amedes/fx25-kiss-tnc/README.md

# FX.25 KISS TNC

KISS TNC program supporing FX.25 error correction protocol.

Hardware components
* TCM3105
* ESP32-WROOM-32
