amedes/fx25-kiss-tnc/manual/FX25-KISS-TNC-manual2.pdf

FX.25 KISS TNC 製作説明書(基本編) 2019/7/19
部品表
部品番号 | 型番/値 | 種類 | 購入情報(通販コード) | 注
A1 | AE-FT234X | USB シリアル I/F | 秋月 M-08461
C1 | 10uF | 積層セラミック | 秋月 P-03095 | 5mm ピッチ
C2,C4,C6, C7,C8,C9,C12 | 0.1uF | 積層セラミック | 秋月 P-04064 | 2.54mm ピッチ
C3,C5 | 1uF | 積層セラミック | 秋月 P-04066 | 2.54mm ピッチ
C10,C11 | 33pF | セラミックコンデンサ | 秋月 P-11138 | ディスク型
D1,D2,D3 | 1SS178 | ダイオード | 秋月 I-07783
D4 | | LED | | 3mm 砲弾型
J1 | MJ-4PP-9 | 3.5φ4 極ジャック | 秋月 C-06070
J2 | B4B-XH-A | ボックスピンヘッダ | 秋月 C-12249 | オプション
J3 | | 2x9 ピンヘッダ | | オプション 2.54mm ピッチ
J4 | PJ-2694 | 2.5φ4 極ジャック | aitendo PJ-2694
JP1 | 2P ピンヘッダ ジャンパーピン | ピンヘッダ ジャンパーピン | 秋月の細ピンヘッダ等 秋月 P03687 等 | 2.54mm ピッチ
Q1,Q2 | DTC143EL | デジタルトランジスタ | 秋月 I-12469
R1,R3,R4, R5,R6*,R7 | 10kΩ | 抵抗 1/6W | 秋月 R-16103
R2 | 100kΩ | 抵抗 1/6W | 秋月 R-16104
R8 | 1kΩ | 抵抗 1/6W | 秋月 R-16102 | LED 用抵抗
RV1 | 50kΩ | 半固定抵抗 | 秋月 P-03281 | Bourns3362P
RV2,RV3 | 100kΩ | 半固定抵抗 | 秋月 P-03283 | Bourns3362P
U1 | ESP-WROOM-32 | WiFi モジュール | 秋月 M-11647
U2 | TCM3105 IC ソケット 16P | モデムチップ IC ソケット | 丹青通商？
U3 | LP2950L-3.3V | レギュレータ | 秋月 I-08749
Y1 | 水晶 4.4336MHz | 水晶発振子 | aitendo HC49S | 4.433619MHz 選択
SW1 | TVBP06-B043CB | タクトスイッチ | 秋月 P-08073

*R6 の抵抗値は無線機の仕様に合わせて下さい

J1/J4 と J2 は無線機との接続に合わせてどちらかあれば OK。
この他に無線機との接続用のケーブルが必要。
(J1/J4 を使う場合は、3.5φミニプラグケーブルと 2.5φミニミニプラグケーブル。J2 を使う場合は、ケーブル を自作する必要がある)
※WiFi を使う場合は、U3 を TA48033S に変更(秋月入手可能，向きに注意。C5,C6 も付属のコンデンサに変え る)。更に AE-FT234X のリセッタブルヒューズを容量の大きいものに取り替える。

※ESP-WROVER-B を使う場合は、C1 を 22uF に替える

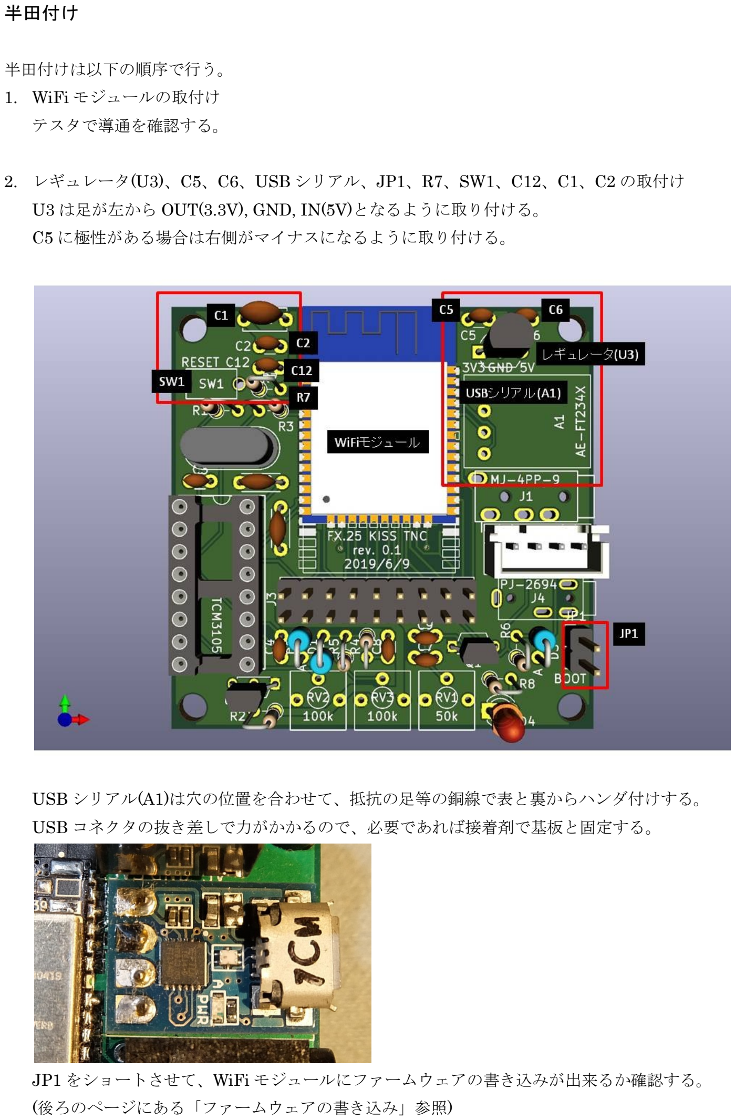
[picture p1: page 2]

半田付け

半田付けは以下の順序で行う。
1. WiFi モジュールの取付け
テスタで導通を確認する。
2. レギュレータ(U3)、C5、C6、USB シリアル、JP1、R7、SW1、C12、C1、C2 の取付け

U3 は足が左から OUT(3.3V), GND, IN(5V)となるように取り付ける。
C5 に極性がある場合は右側がマイナスになるように取り付ける。

USB シリアル(A1)は穴の位置を合わせて、抵抗の足等の銅線で表と裏からハンダ付けする。 USB コネクタの抜き差しで力がかかるので、必要であれば接着剤で基板と固定する。

JP1 をショートさせて、WiFi モジュールにファームウェアの書き込みが出来るか確認する。 (後ろのページにある「ファームウェアの書き込み」参照)

3. 残りの部品の半田付け
Q1 は型番が読める向きに取り付ける(足が左から 1,2,3 の順)。

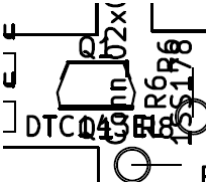
[picture p2: figure]

Q2 は型番の面を奥に向ける(足が左から 3,2,1 の順)。

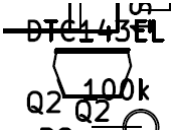
[picture p3: figure]

ダイオードはランドが四角の側(シルクの○がある側)がカソードとなるように取り付ける。

4. つなぐ無線機に合わせて JP2,JP3,JP4,JP5 の半田ジャンパを設定 アイコム／スタンダード
JP2：ショート
JP3：1-2 間をショート
JP4：JP4 の 1 と 2.5φジャックの端子 2 をジャンパでショートする JP5：オープン

ケンウッド
JP2：オープン
JP3：2-3 間をショート
JP4：JP4 の 3 と 2.5φジャックの端子 2 をジャンパでショートする JP5：ショート

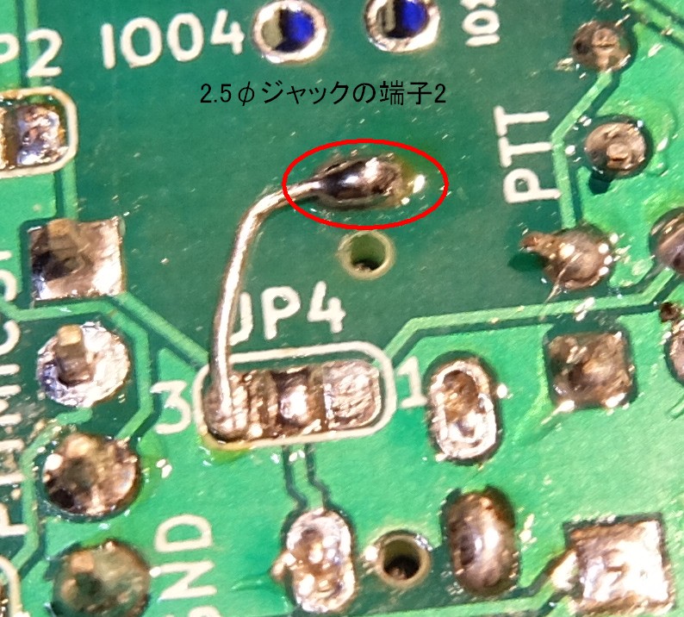
[picture p4: figure]

調整

TCM3105 の RXB(7 ピン)を 2.7V に RV2(左)で調整、CDL(10 ピン)を 3.3V に RV3(中央)で調整する。 RV1(右)で送信レベルを調整する。

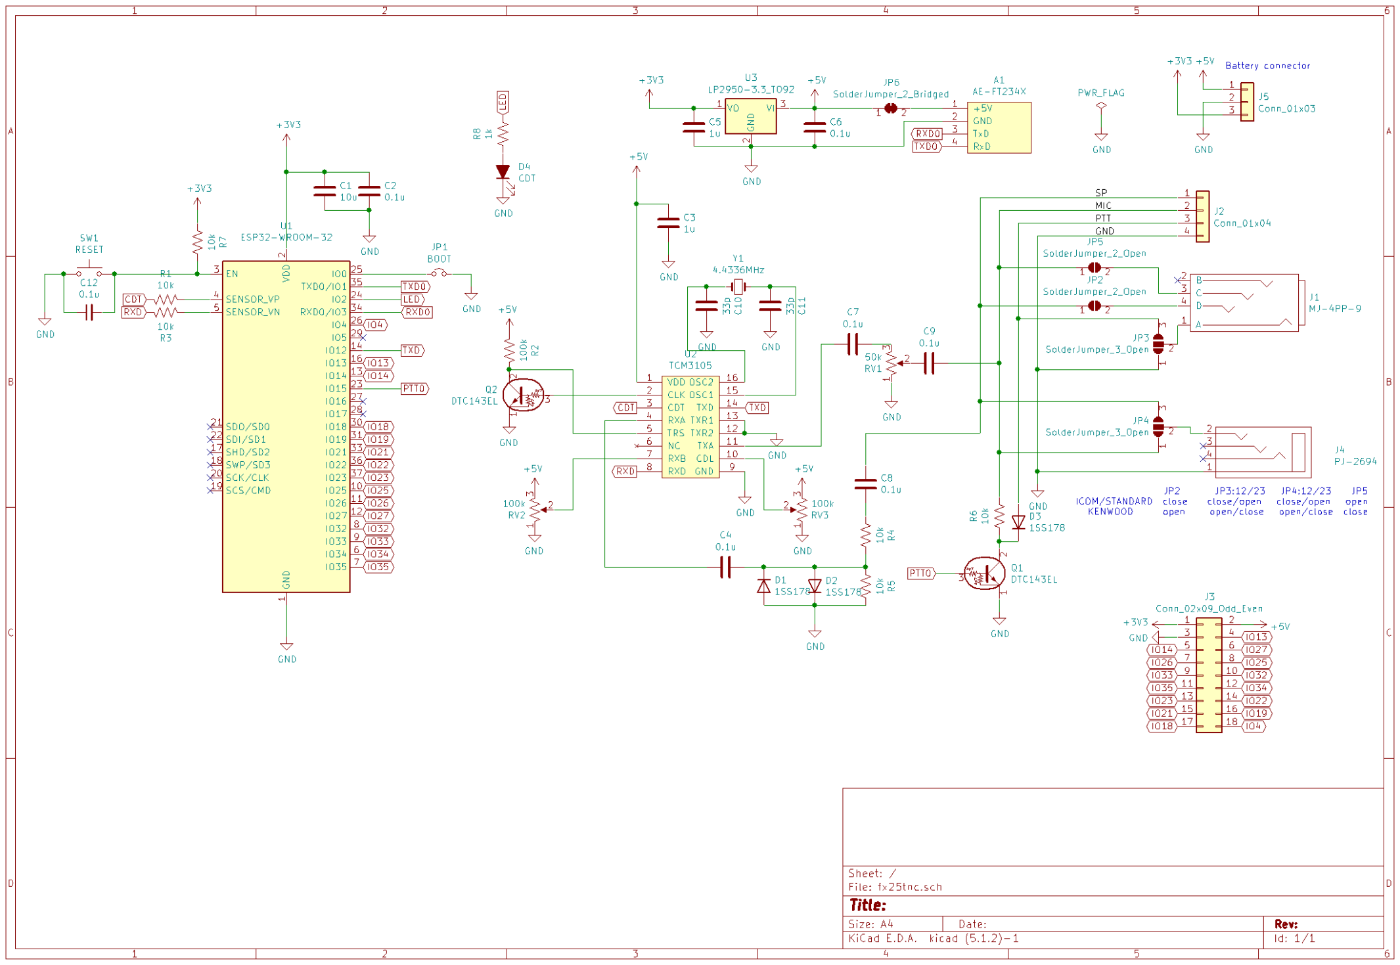
[picture p5: page 5]

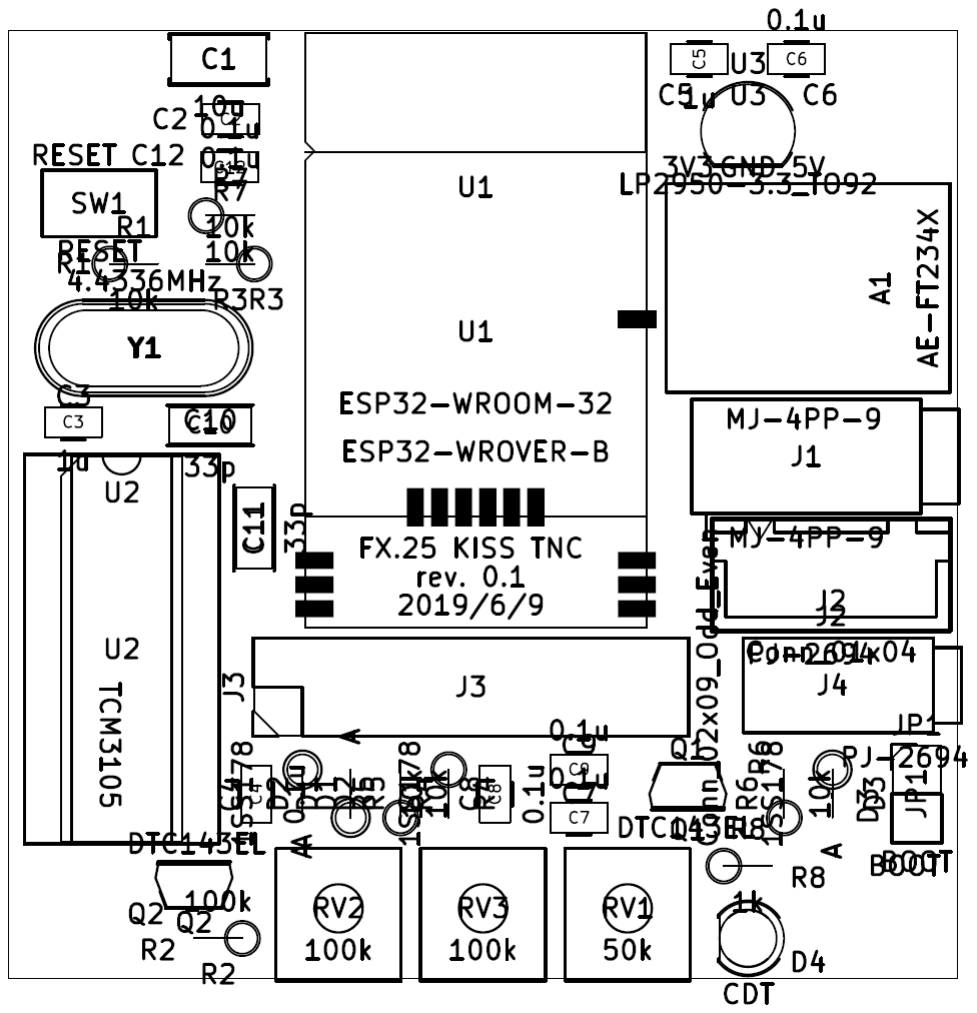
[picture p6: figure]

部品配置

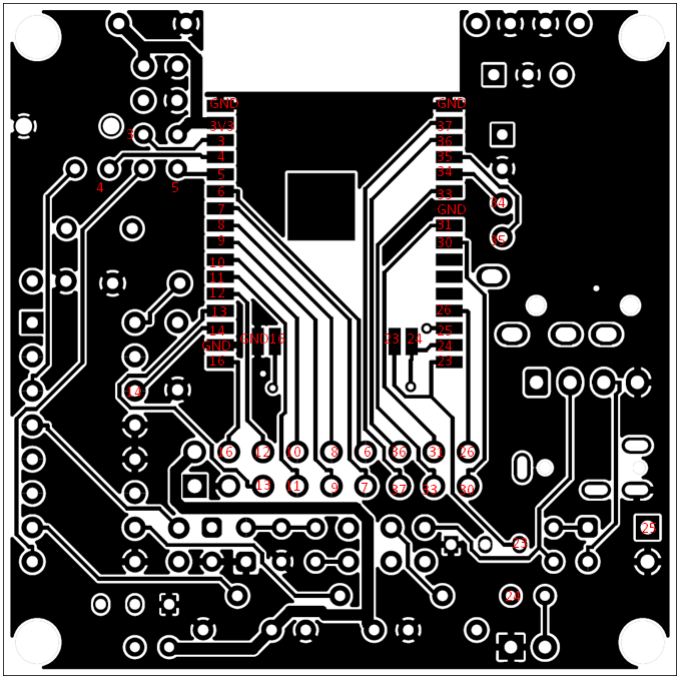
[picture p7: figure]

ESP-WROOM-32 の半田付け確認用接続図

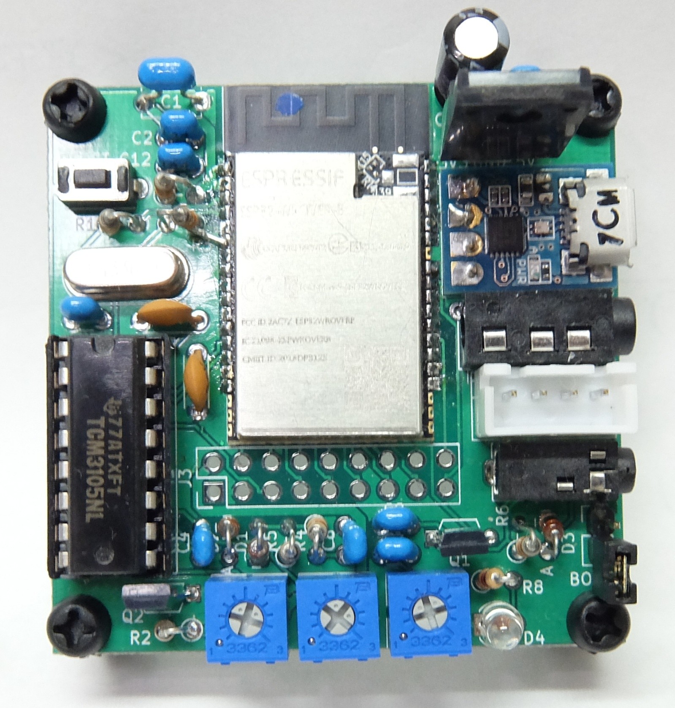
[picture p8: figure]

完成品

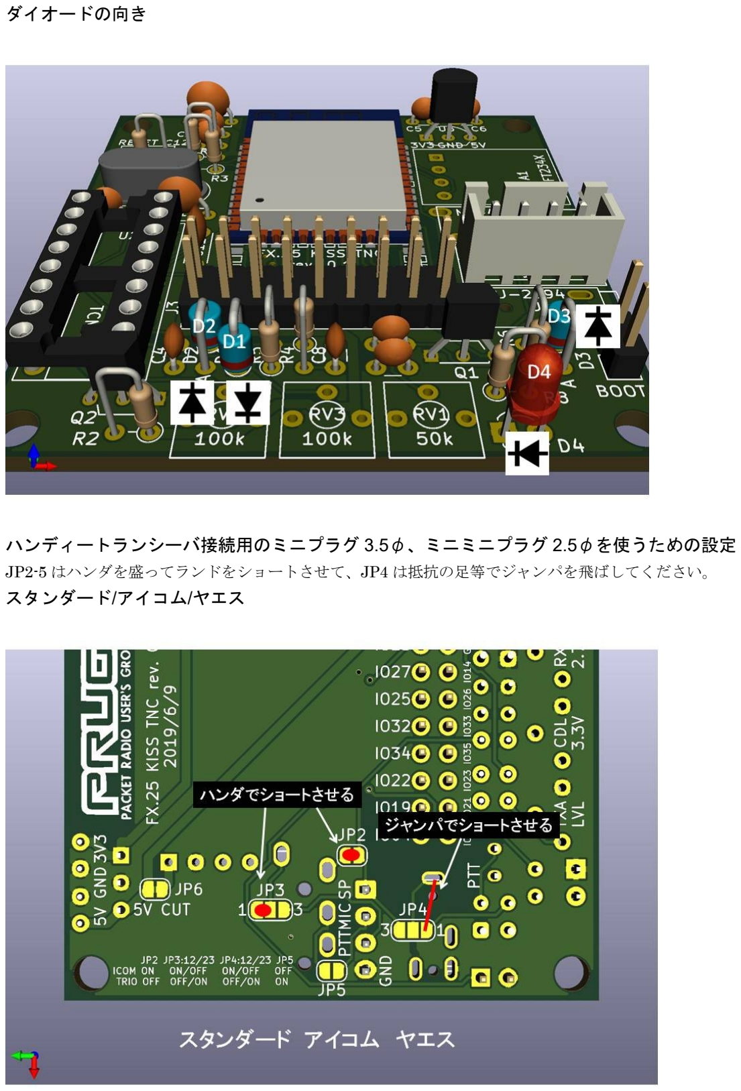
[picture p9: page 9]

ダイオードの向き

ハンディートランシーバ接続用のミニプラグ 3.5φ、ミニミニプラグ 2.5φを使うための設定

JP2-5 はハンダを盛ってランドをショートさせて、JP4 は抵抗の足等でジャンパを飛ばしてください。 スタンダード/アイコム/ヤエス

ケンウッド

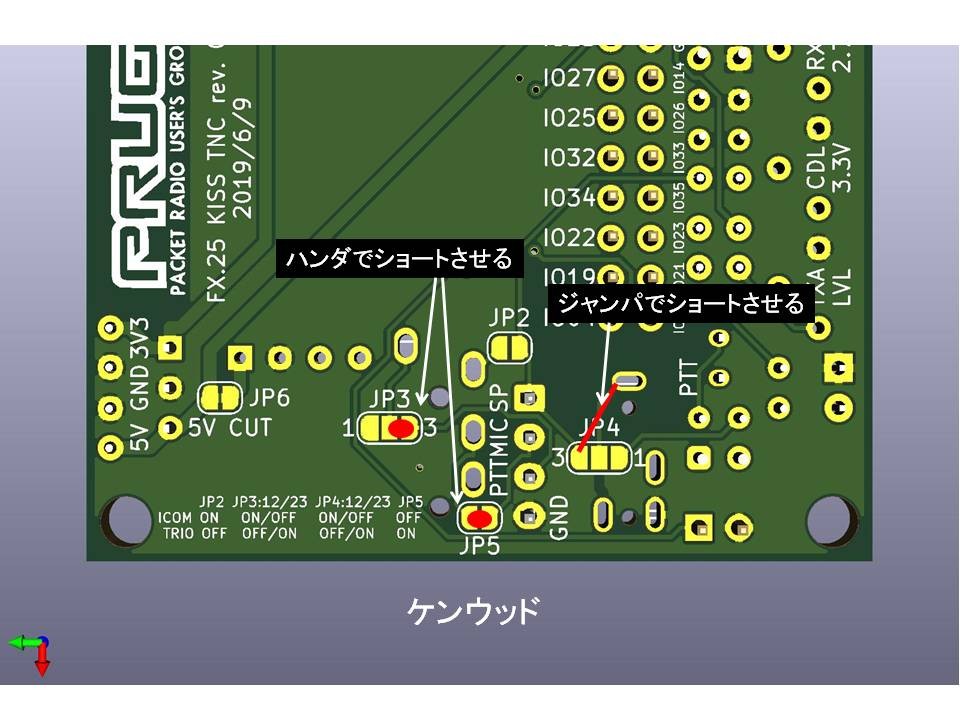
[picture p10: figure]

ファームウェアの書き込み(GNU Make Build System 用の説明)

ファームウェアの書き込みは、WROOM32 の開発環境をインストールして、GitHub から FX25 TNC のソース コードを持ってきて、コンパイルして WROOM32 へシリアル経由で書き込みます。

WROOM32 の開発環境(ESP-IDF)のインストール

下記の URL の Get Started 等を参考に開発環境をインストールします。

ESP-IDF Programming Guide — ESP-IDF Programming Guide

https://docs.espressif.com/projects/esp-idf/en/stable/

Get Started — ESP-IDF Programming Guide v3.2.2 documentation

https://docs.espressif.com/projects/esp-idf/en/stable/get-started/

具体的には URL を参照して以下の 4 項目を実行します。
Windows 環境のツールの設定

Standard Setup of Toolchain for Windows — ESP-IDF Programming Guide v3.2.2 documentation

https://docs.espressif.com/projects/esp-idf/en/stable/get-started/windows-setup.html#toolchain-setup

開発環境 ESP-IDF の取得

Get Started — ESP-IDF Programming Guide v3.2.2 documentation

https://docs.espressif.com/projects/esp-idf/en/stable/get-started/index.html#get-started-get-esp-idf

ESP-IDF の Path の設定

Get Started — ESP-IDF Programming Guide v3.2.2 documentation

https://docs.espressif.com/projects/esp-idf/en/stable/get-started/index.html#setup-path-to-esp-idf

必要な Python のパッケージのインストール

Get Started — ESP-IDF Programming Guide v3.2.2 documentation

https://docs.espressif.com/projects/esp-idf/en/stable/get-started/index.html#install-the-required-python-pack

ages (https://docs.espressif.com/projects/esp-idf/en/stable/get-started/index.html)

FX25 TNC のソースコードの入手

ESP-IDF の shell 上で、

git clone https://github.com/amedes/fx25-kiss-tnc.git

とすると、fx25-kiss-tnc というディレクトリ以下にソースが入ります。

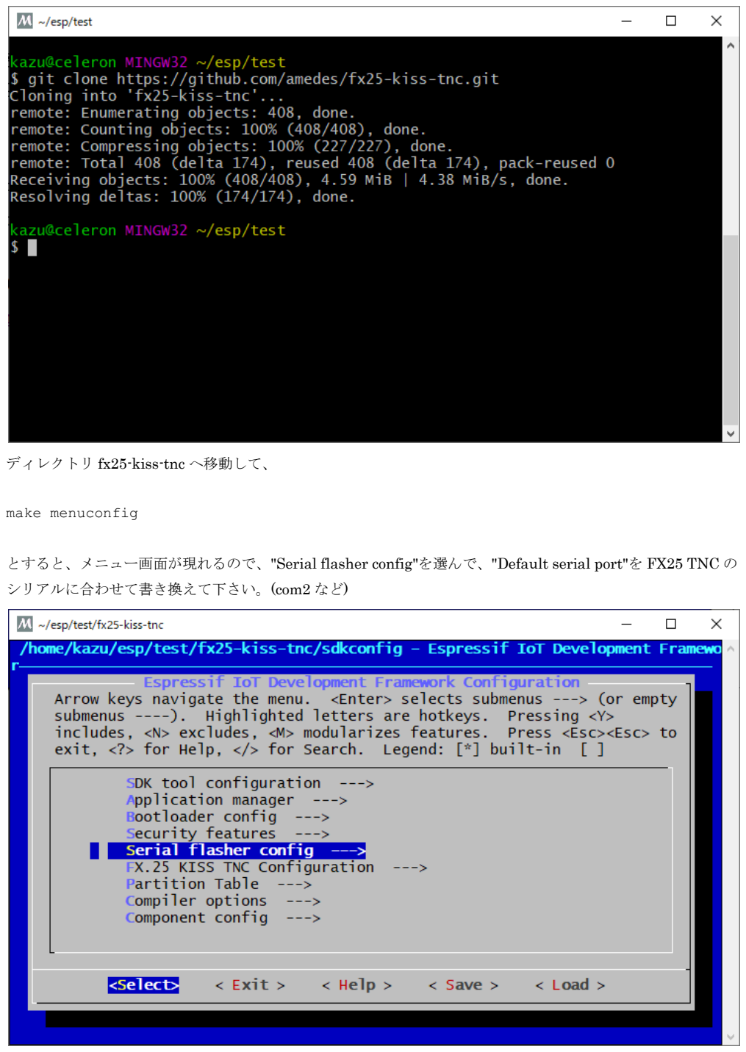
[picture p11: page 12]

ディレクトリ fx25-kiss-tnc へ移動して、

make menuconfig

とすると、メニュー画面が現れるので、"Serial flasher config"を選んで、"Default serial port"を FX25 TNC の シリアルに合わせて書き換えて下さい。(com2 など)

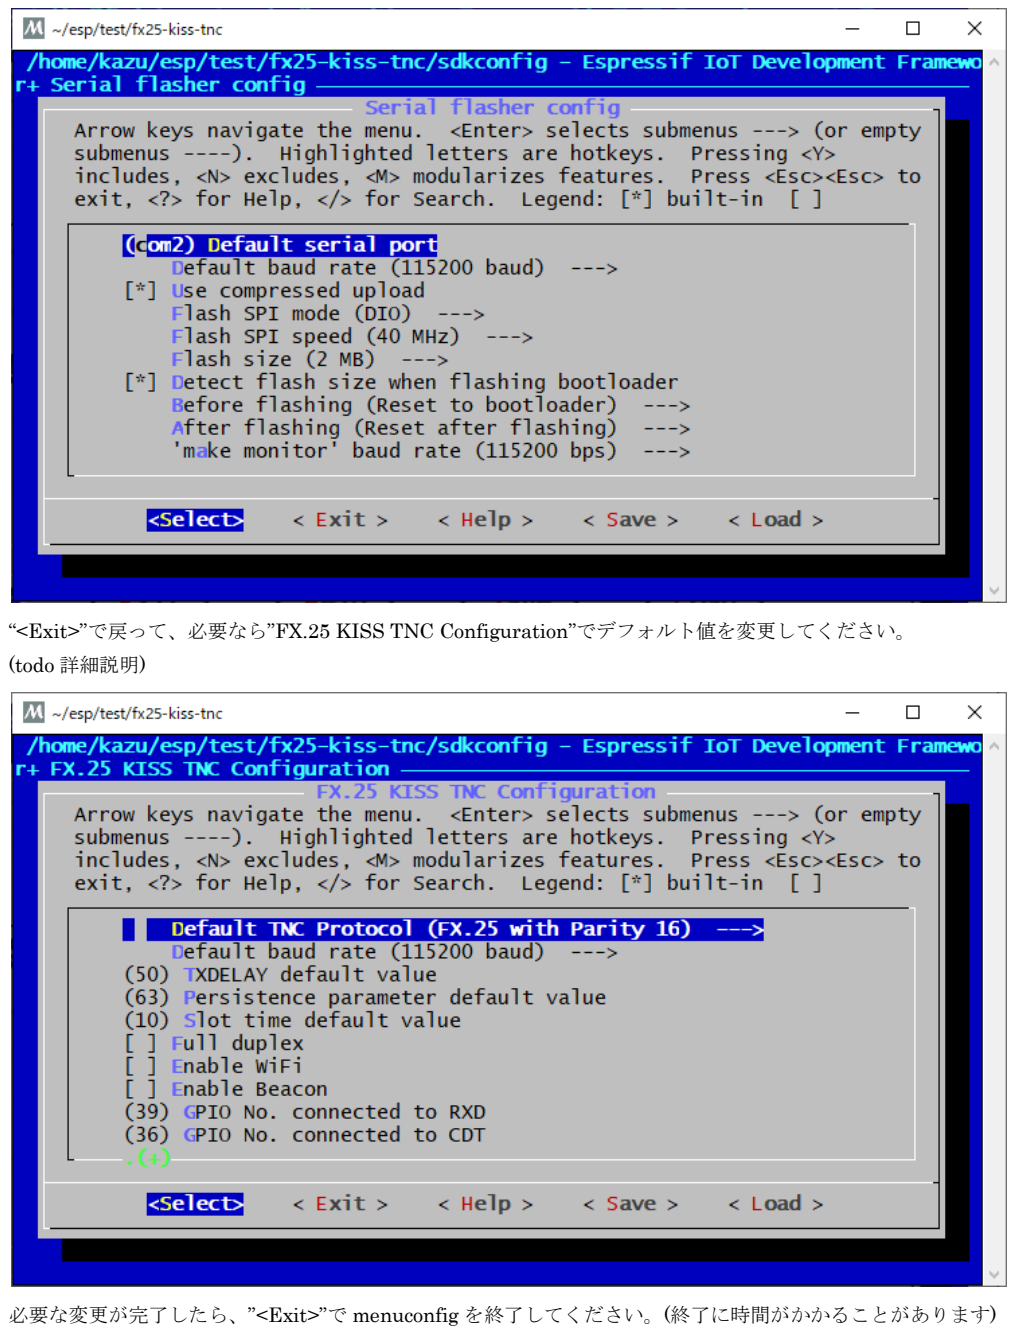
[picture p12: page 13]

“<Exit>”で戻って、必要なら”FX.25 KISS TNC Configuration”でデフォルト値を変更してください。

(todo 詳細説明)

必要な変更が完了したら、”<Exit>”で menuconfig を終了してください。(終了に時間がかかることがあります)

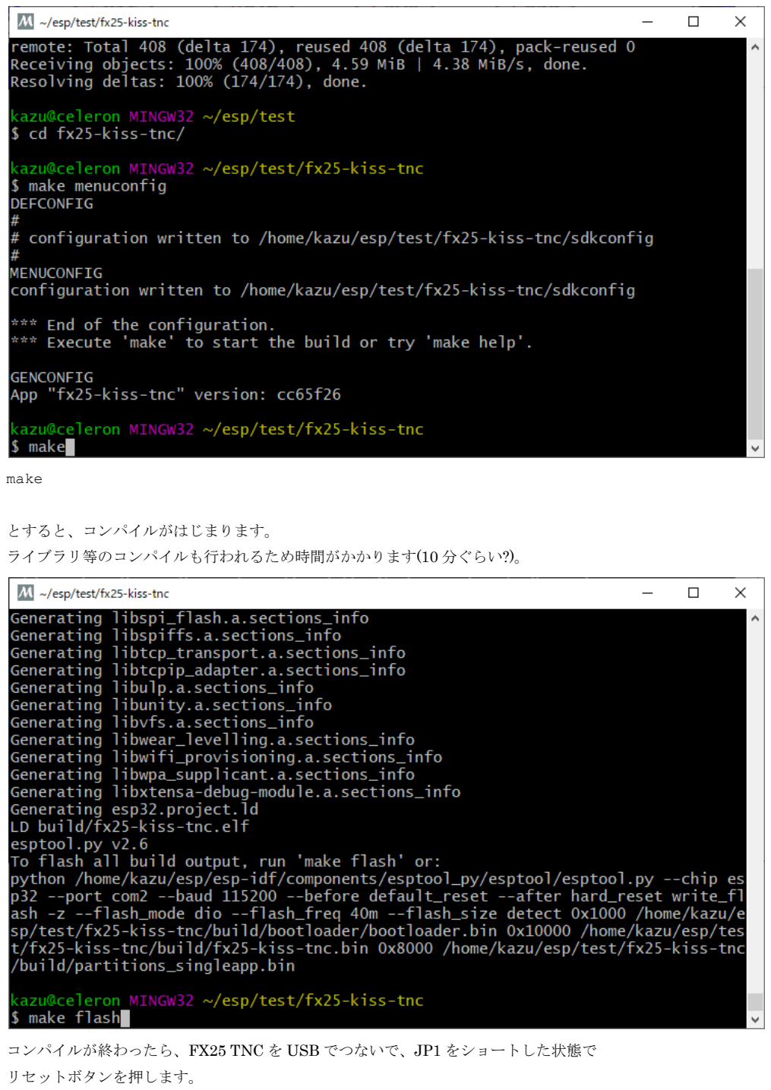
[picture p13: page 14]

make

とすると、コンパイルがはじまります。
ライブラリ等のコンパイルも行われるため時間がかかります(10 分ぐらい?)。

コンパイルが終わったら、FX25 TNC を USB でつないで、JP1 をショートした状態で リセットボタンを押します。

make flash

とするとファームウェアの書き込みが行われます。

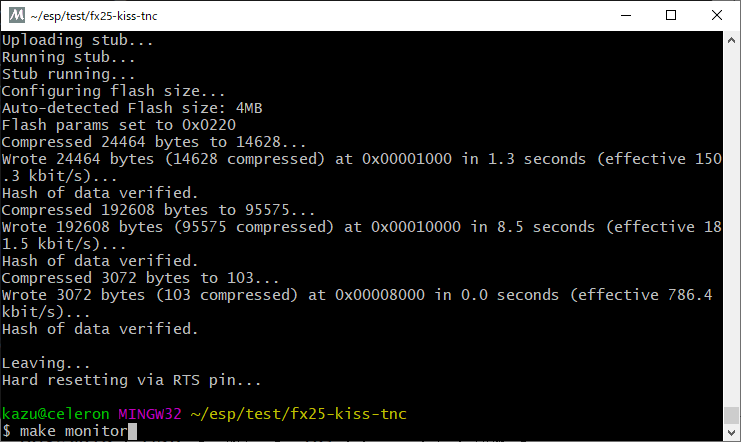
[picture p14: figure]

JP1 をオープンにしてリセットすると TNC が動作を始めます。

make monitor

とするとシリアルを監視できます。リセットするとブートメッセージが表示されるはずです。抜けるには

Control-]です。

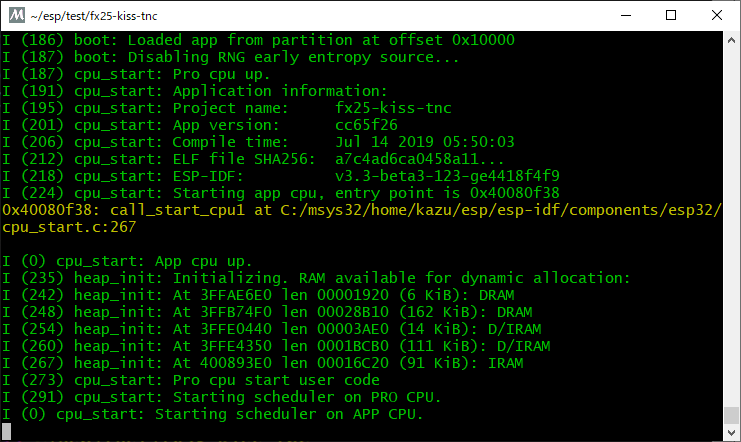
[picture p15: figure]

以上

ESP-IDF v4.x 用の説明
ファームウェアの書き込み(ESP-IDF Tools installer 用の説明)

ファームウェアの書き込みは、WROOM32 の開発環境をインストールして、GitHub から FX25 TNC のソース コードを持ってきて、コンパイルして WROOM32 へシリアル経由で書き込みます。

WROOM32 の開発環境(ESP-IDF)のインストール

下記の URL の Get Started 等を参考に開発環境をインストールします。

ESP-IDF Programming Guide — ESP-IDF Programming Guide

https://docs.espressif.com/projects/esp-idf/en/latest/

FX25 TNC のソースコードの入手

スタートメニューから ESP-IDF Command Prompt (cmd.exe)を起動して、

git clone https://github.com/amedes/fx25-kiss-tnc.git

とすると、fx25-kiss-tnc というディレクトリ以下にソースが入ります。

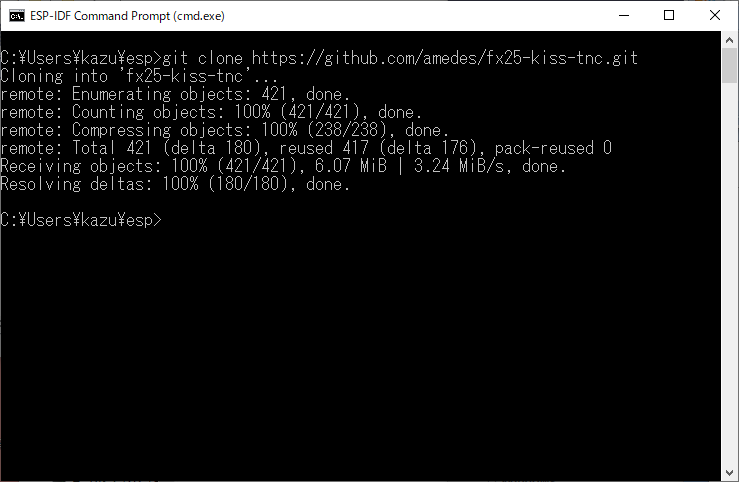
[picture p16: figure]

cd fx25-kiss-tnc

idf.py menuconfig

で FX25 TNC の KISS モードのディフォルト値等を変更することが出来ます。

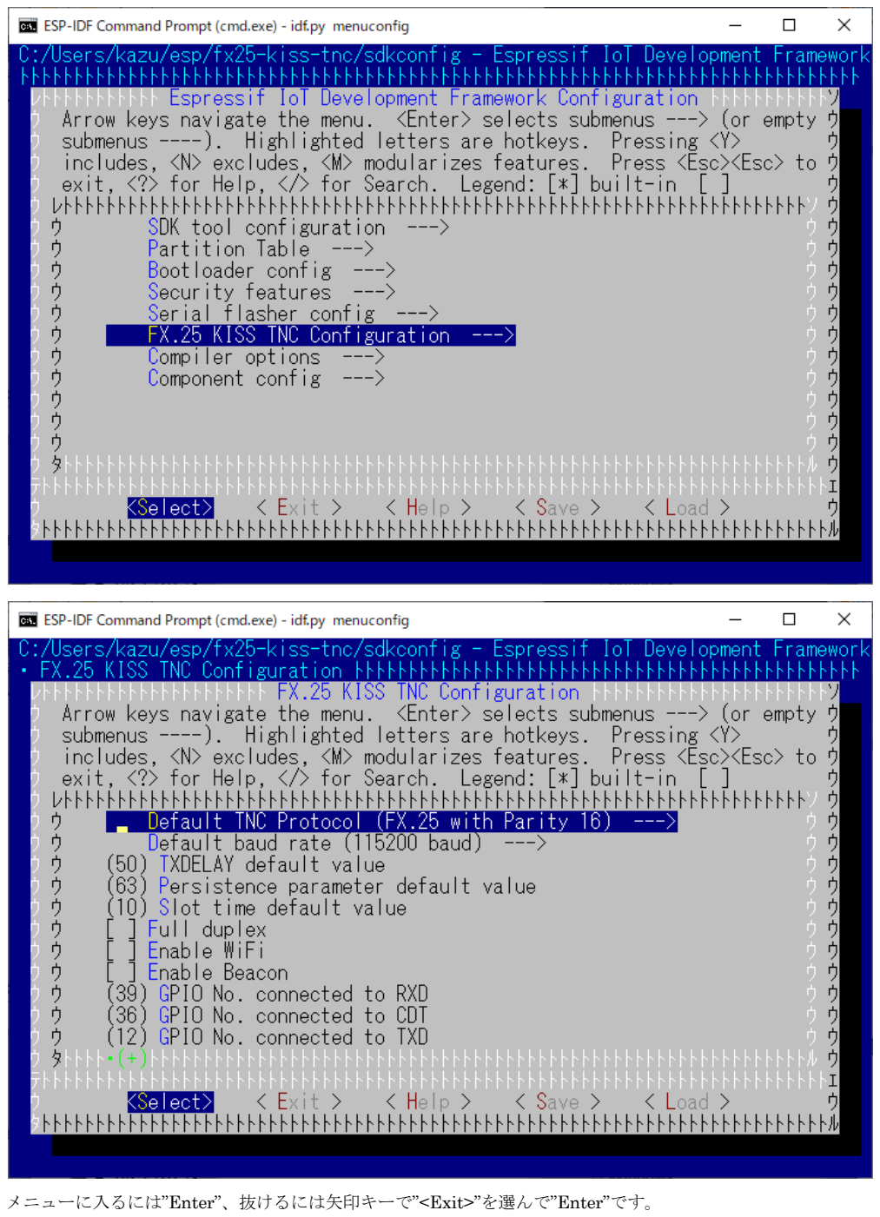
[picture p17: page 18]

メニューに入るには”Enter”、抜けるには矢印キーで”<Exit>”を選んで”Enter”です。

ファームウェアのコンパイルは、

idf.py build

です。

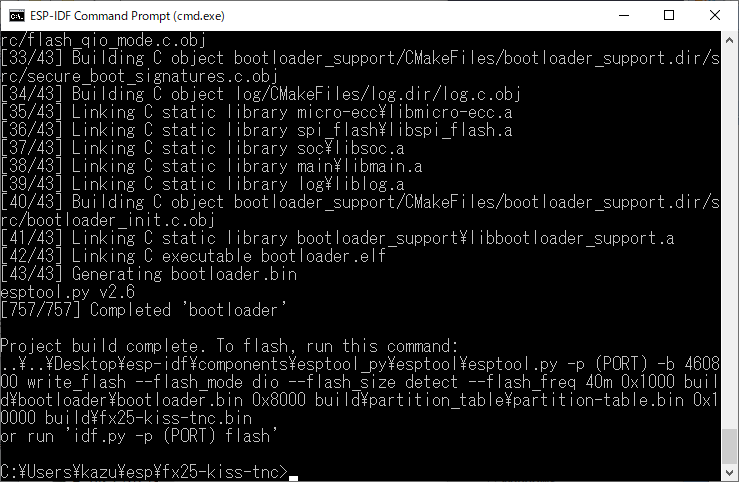
[picture p18: figure]

ファームウェアの書き込みは、PC と TNC を USB ケーブルで接続して JP1 をショートしてリセットボタンを押 してください。この状態で、

idf.py –p com1 flash

と入力するとファームウェアの書き込みが行われます。com1 の部分は USB シリアルのポート番号に合わせてく ださい。

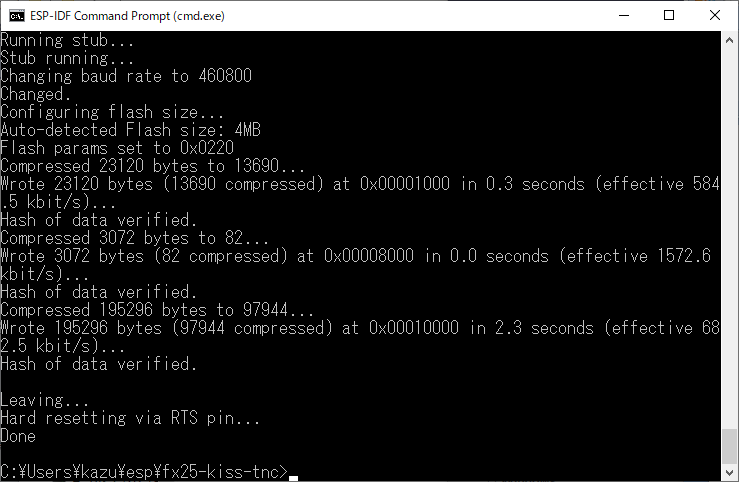
[picture p19: figure]

TNC のシリアル出力をモニターするには、

idf.py –p com1 monitor

としてください。この状態で JP1 をオープンにしてリセットボタンを押すとブートメッセージが表示されるはず です。

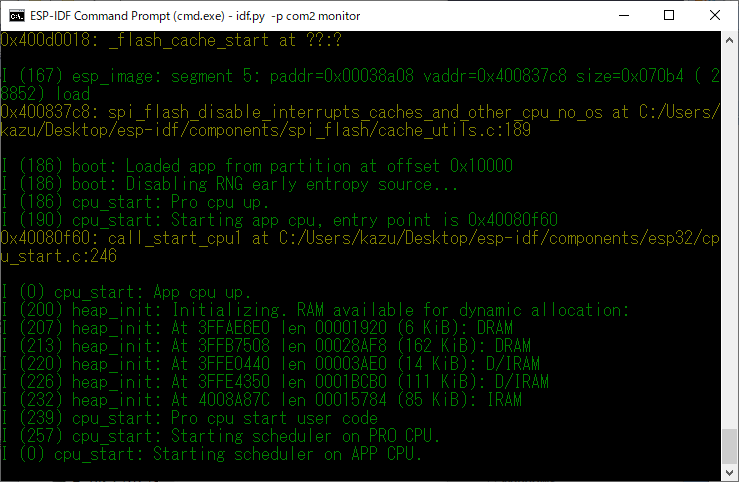
[picture p20: figure]

この状態で FX25 TNC は KISS モードで動作しています。
デフォルトのボーレートは 115200bps です。ボーレートは”idf.py menuconfig”のメニューで変更可能です。 適切なソフトウェアを用いれば、KISS モードでパケットの送受信が行えるはずです。

ファームウェアの書き込み(Legacy GNU Make Build System 用の説明)

ファームウェアの書き込みは、WROOM32 の開発環境をインストールして、GitHub から FX25 TNC のソース コードを持ってきて、コンパイルして WROOM32 へシリアル経由で書き込みます。

WROOM32 の開発環境(ESP-IDF)のインストール

下記の URL の Get Started 等を参考に開発環境をインストールします。

ESP-IDF Programming Guide — ESP-IDF Programming Guide

https://docs.espressif.com/projects/esp-idf/en/latest/

FX25 TNC のソースコードの入手

ESP-IDF の shell 上で、

git clone https://github.com/amedes/fx25-kiss-tnc.git

とすると、fx25-kiss-tnc というディレクトリ以下にソースが入ります。

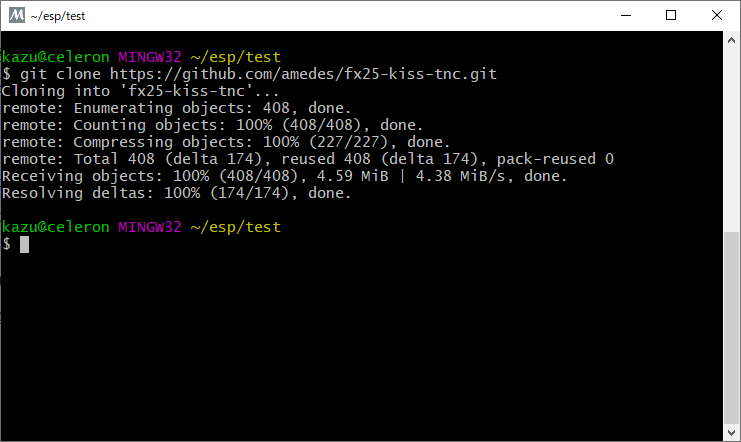
[picture p21: figure]

ディレクトリ fx25-kiss-tnc へ移動して、

make menuconfig

とすると、メニュー画面が現れるので、"Serial flasher config"を選んで、"Default serial port"を FX25 TNC の シリアルに合わせて書き換えて下さい。(com2 など)

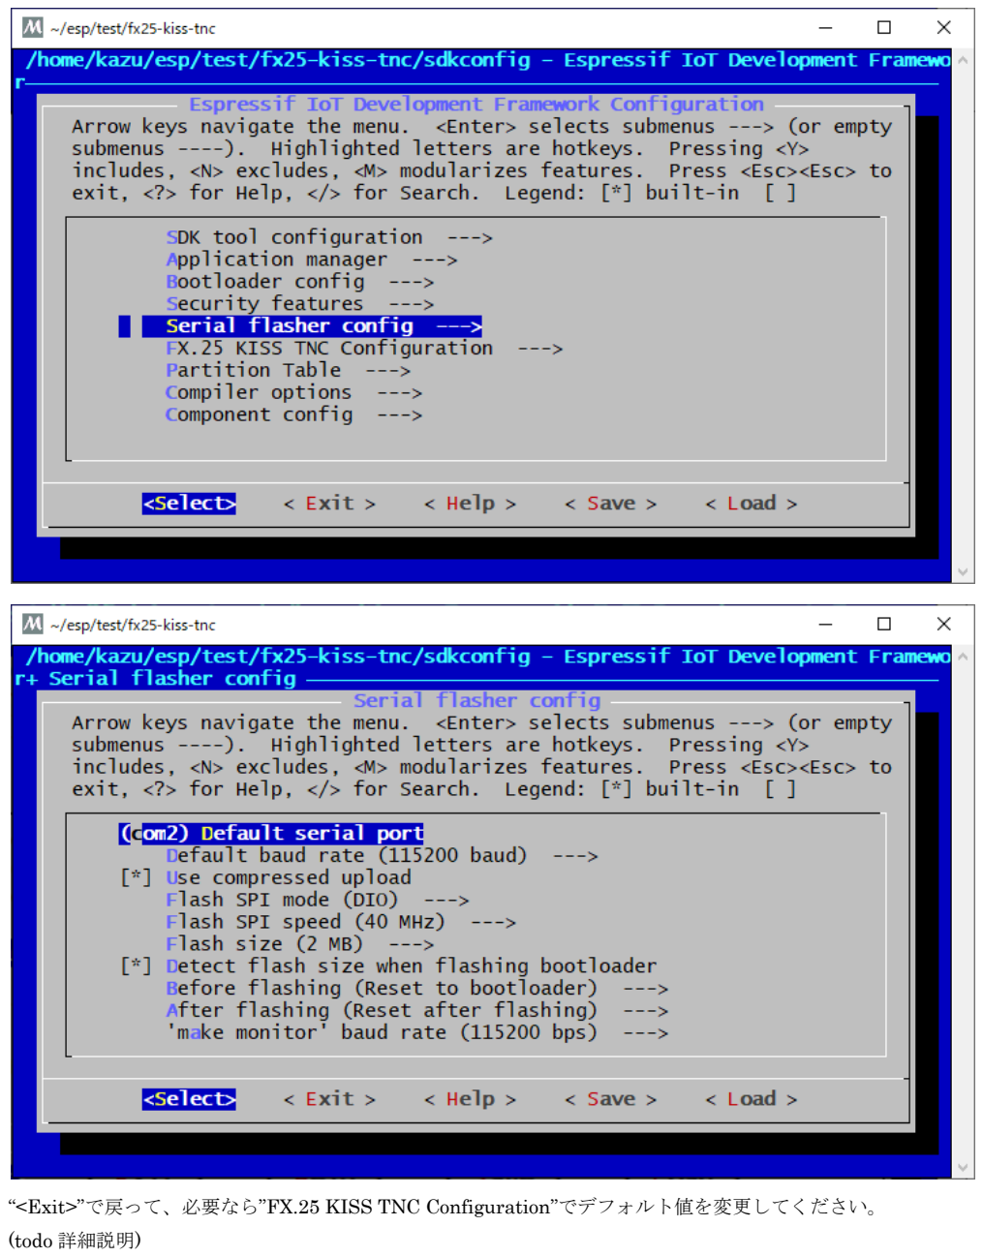
[picture p22: page 23]

“<Exit>”で戻って、必要なら”FX.25 KISS TNC Configuration”でデフォルト値を変更してください。

(todo 詳細説明)

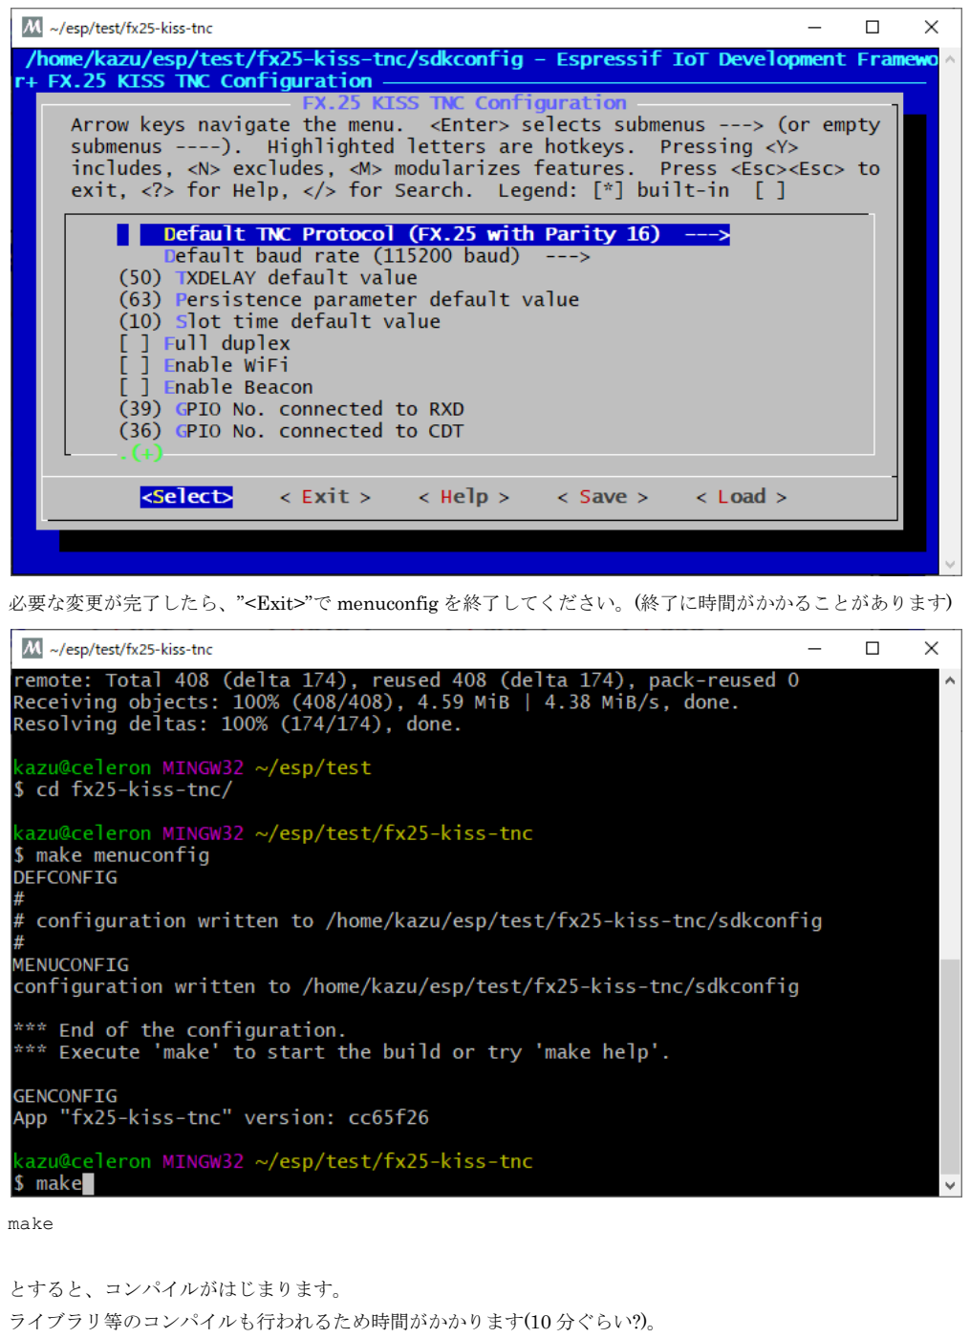
[picture p23: page 24]

必要な変更が完了したら、”<Exit>”で menuconfig を終了してください。(終了に時間がかかることがあります)

make

とすると、コンパイルがはじまります。
ライブラリ等のコンパイルも行われるため時間がかかります(10 分ぐらい?)。

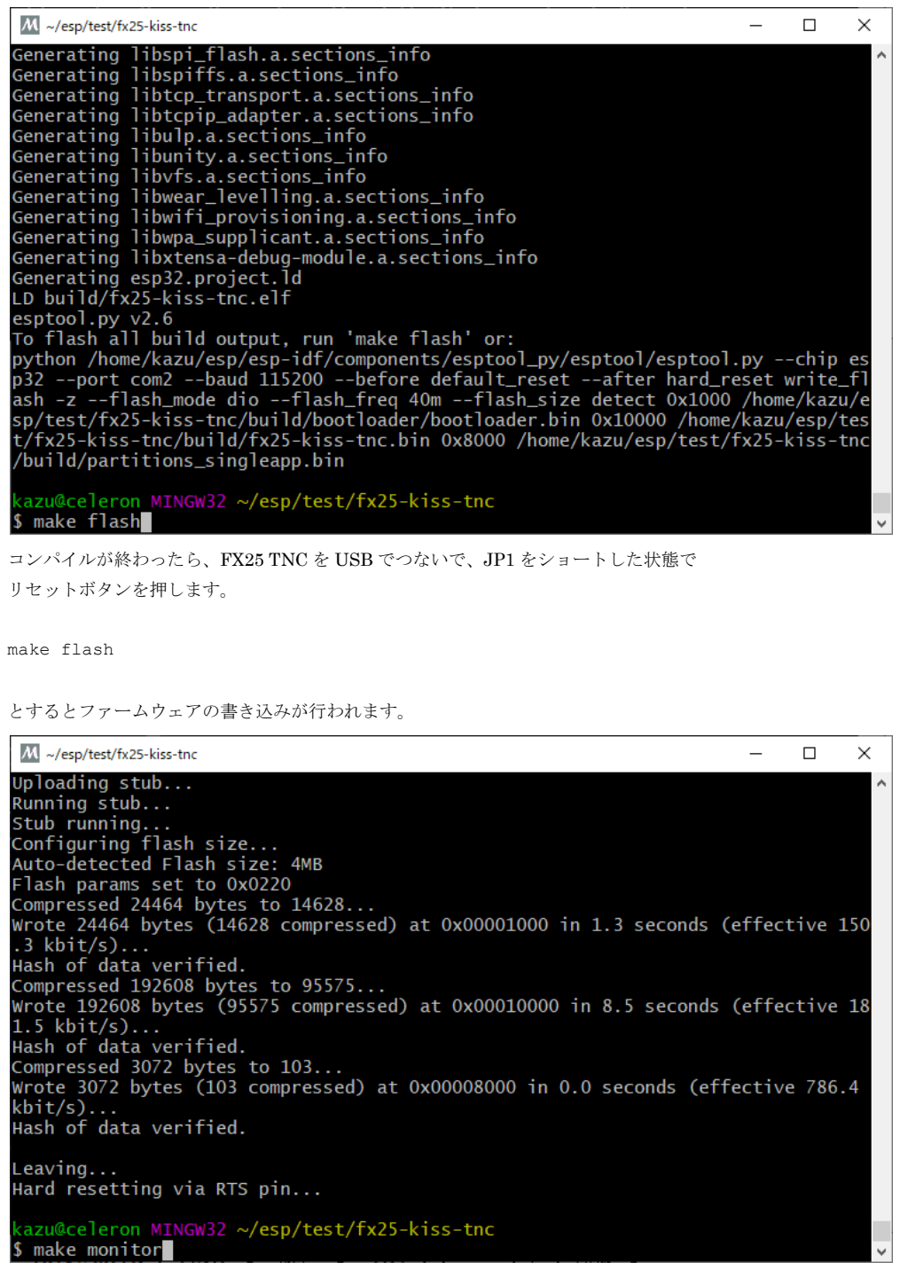
[picture p24: page 25]

コンパイルが終わったら、FX25 TNC を USB でつないで、JP1 をショートした状態で リセットボタンを押します。

make flash

とするとファームウェアの書き込みが行われます。

JP1 をオープンにしてリセットすると TNC が動作を始めます。

make monitor

とするとシリアルを監視できます。リセットするとブートメッセージが表示されるはずです。抜けるには

Control-]です。

以上
