amedes/fx25-kiss-tnc/KiCad/fx25tnc.kicad_pcb

## KiCad design KiCad/fx25tnc.kicad_pcb (2019-07-01)

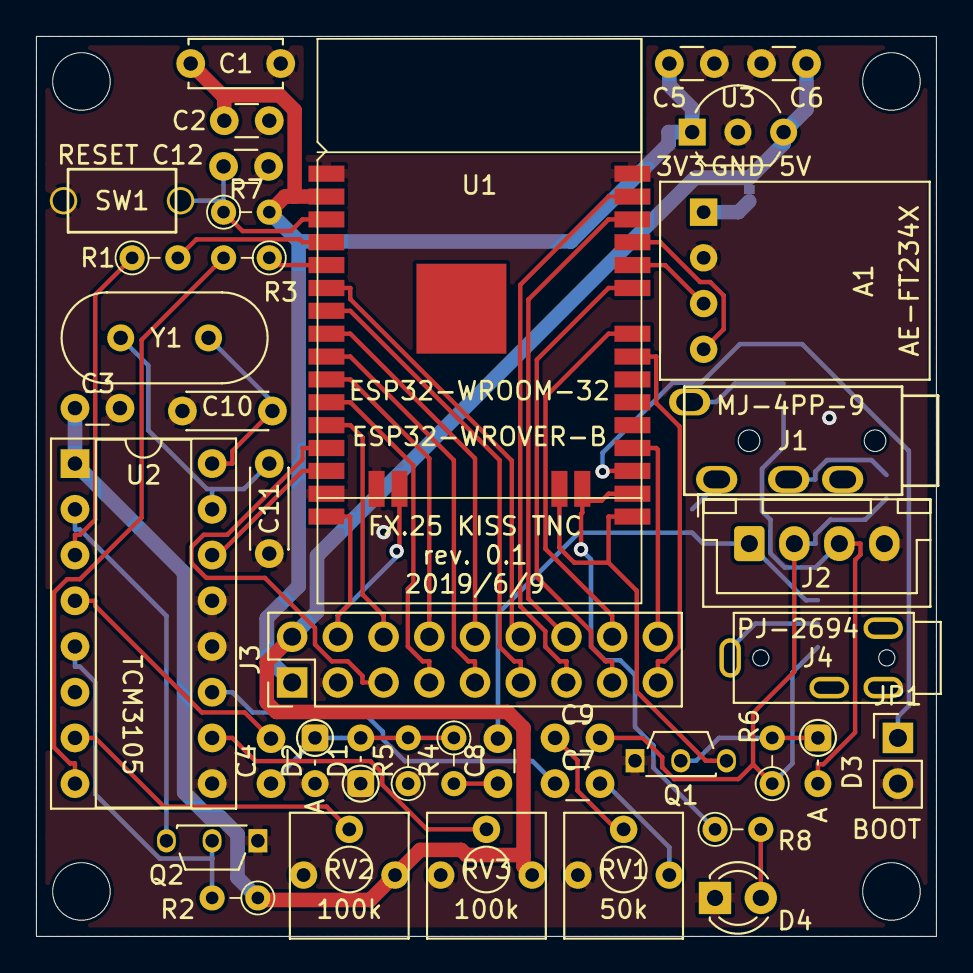
[picture p25: board fx25tnc.kicad_pcb from above]

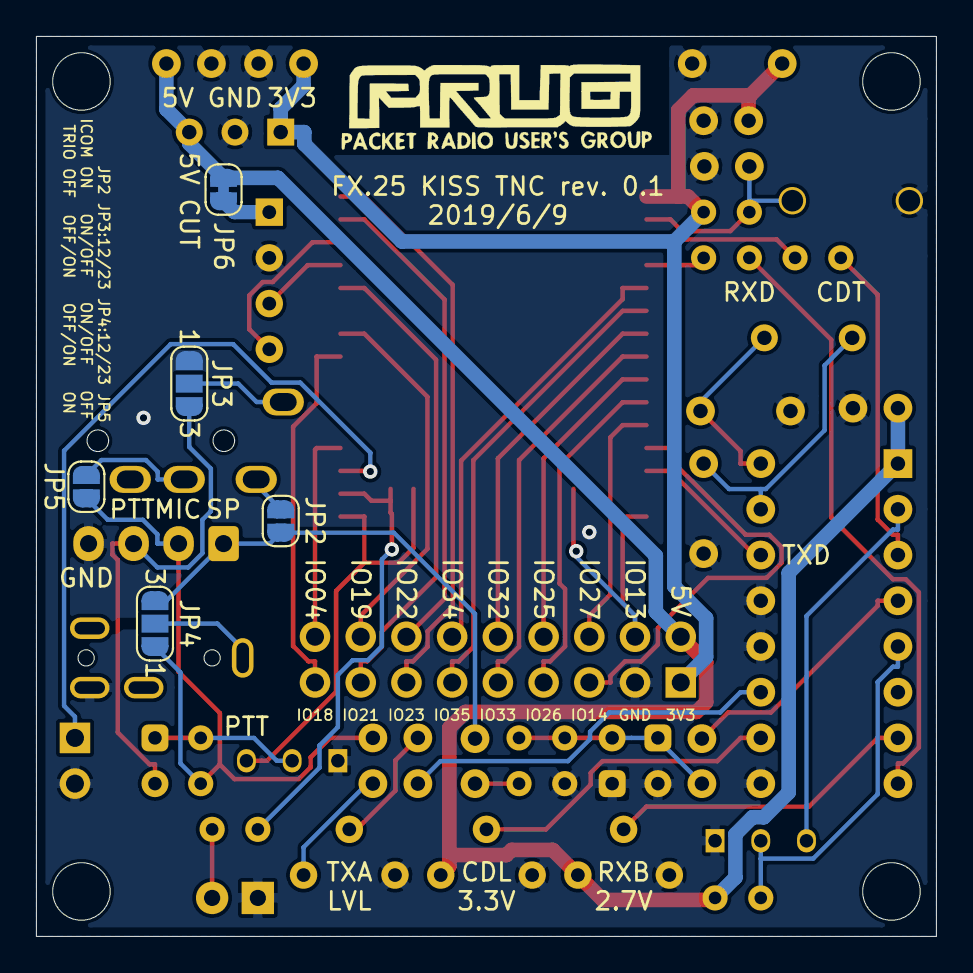
[picture p26: board fx25tnc.kicad_pcb from below]

Board: 2 copper layers, 50.0 x 50.0 mm, 49 parts (5 on the bottom side), 51 nets.

Parts:
A1: AE-FT234X
C1: 10u; C_Disc_D5.0mm_W2.5mm_P5.00mm
C2, C4, C6, C7, C8, C9, C12: 0.1u; C_Disc_D3.0mm_W1.6mm_P2.50mm
C3, C5: 1u; C_Disc_D3.0mm_W1.6mm_P2.50mm
C10, C11: 33p; C_Disc_D4.3mm_W1.9mm_P5.00mm
D1, D2, D3: 1SS178; D_DO-34_SOD68_P2.54mm_Vertical_AnodeUp
D4: CDT; LED_D3.0mm
J1: MJ-4PP-9
J2: Conn_01x04; JST_XH_B4B-XH-A_1x04_P2.50mm_Vertical
J3: Conn_02x09_Odd_Even; PinHeader_2x09_P2.54mm_Vertical
J4: PJ-2694; Jack_2.5mm_PJ2964
JP1: BOOT; PinHeader_1x02_P2.54mm_Vertical
JP2, JP5: SolderJumper_2_Open; SolderJumper-2_P1.3mm_Open_RoundedPad1.0x1.5mm
JP3, JP4: SolderJumper_3_Open; SolderJumper-3_P1.3mm_Open_RoundedPad1.0x1.5mm_NumberLabels
JP6: SolderJumper_2_Bridged; SolderJumper-2_P1.3mm_Bridged_RoundedPad1.0x1.5mm
MH1, MH2, MH3, MH4: MountingHole_3.2mm_M3
Q1, Q2: DTC143EL; TO-92S_Wide
R1, R3, R4, R5, R6, R7: 10k; R_Axial_DIN0204_L3.6mm_D1.6mm_P2.54mm_Vertical
R2: 100k; R_Axial_DIN0204_L3.6mm_D1.6mm_P2.54mm_Vertical
R8: 1k; R_Axial_DIN0204_L3.6mm_D1.6mm_P2.54mm_Vertical
RV1: 50k; BOURNS_362P
RV2, RV3: 100k; BOURNS_362P
SW1: RESET; TACTSW_6x3.5mm_TH
U1: ESP32-WROOM-32; ESP32-WROVER
U2: TCM3105; DIP-16_W7.62mm_Socket
U3: LP2950-3.3_TO92; TO-92_Inline_Wide
Y1: 4.4336MHz; Crystal_HC49-4H_Vertical

Connections:
+3V3: C1.1, C2.1, C5.1, J3.1, R7.2, U1.2, U3.1
+5V: C3.1, C6.1, J3.2, JP6.1, R2.1, RV2.3, RV3.3, U2.1, U3.3
/MIC: C9.1, J2.2, JP4.1, JP5.1, R6.1
/PTT: D3.2, J2.3, JP3.3
/SP: C8.2, J2.1, JP2.1, JP4.3
CDT: R1.1, U2.3
GND: A1.2, C1.2, C2.2, C3.2, C5.2, C6.2, C10.1, C11.1, C12.1, D1.1, D2.2, D4.1, J2.4, J3.3, J4.1, JP1.2, JP3.1, Q1.1, Q2.1, R5.1, RV1.1, RV2.1, RV3.1, SW1.1, U1.1, U1.15, U1.38, U2.9, U2.12, U2.13, U3.2
IO4: J3.18, U1.26
IO13: J3.4, U1.16
IO14: J3.5, U1.13
IO18: J3.17, U1.30
IO19: J3.16, U1.31
IO21: J3.15, U1.33
IO22: J3.14, U1.36
IO23: J3.13, U1.37
IO25: J3.8, U1.10
IO26: J3.7, U1.11
IO27: J3.6, U1.12
IO32: J3.10, U1.8
IO33: J3.9, U1.9
IO34: J3.12, U1.6
IO35: J3.11, U1.7
LED: R8.1, U1.24
unnamed: A1.1, JP6.2
unnamed: C4.1, D1.2, D2.1, R4.1, R5.2
unnamed: C4.2, U2.4
unnamed: C7.1, RV1.3
unnamed: C7.2, U2.11
unnamed: C8.1, R4.2
unnamed: C9.2, RV1.2
unnamed: C10.2, U2.16, Y1.1
unnamed: C11.2, U2.15, Y1.2
unnamed: C12.2, R7.1, SW1.2, U1.3
unnamed: D3.1, Q1.2, R6.2
unnamed: D4.2, R8.2
unnamed: J1.1, JP3.2
unnamed: J1.3, JP5.2
unnamed: J1.4, JP2.2
unnamed: J4.2, JP4.2
unnamed: JP1.1, U1.25
unnamed: Q2.2, R2.2, U2.5
unnamed: Q2.3, U2.2
unnamed: R1.2, U1.4
unnamed: R3.1, U1.5
unnamed: RV2.2, U2.7
unnamed: RV3.2, U2.10
PTT0: Q1.3, U1.23
RXD: R3.2, U2.8
RXD0: A1.3, U1.34
TXD: U1.14, U2.14
TXD0: A1.4, U1.35
