amedes/fx25-kiss-tnc/main/packet_table.c

const unsigned char packet_table[] = {
    0x54, 0x82, 0xa0, 0xa4, 0xa6, 0x40, 0x40, 0x60, 0xae, 0x82, 0x6c, 0xb2, 0x98, 0x84, 0x68, 0x9c,
    0x6c, 0x8a, 0xb0, 0x40, 0x40, 0xeb, 0x03, 0xf0, 0x24, 0x55, 0x4c, 0x54, 0x57, 0x30, 0x30, 0x30,
    0x30, 0x30, 0x30, 0x30, 0x30, 0x2d, 0x2d, 0x2d, 0x2d, 0x30, 0x30, 0x30, 0x30, 0x2d, 0x2d, 0x2d,
    0x2d, 0x30, 0x30, 0x30, 0x30, 0x38, 0x36, 0x41, 0x30, 0x30, 0x30, 0x30, 0x31, 0x2d, 0x2d, 0x2d,
    0x2d, 0x30, 0x30, 0x30, 0x30, 0x30, 0x30, 0x30, 0x30, 0x30, 0x30, 0x30, 0x30, 0x30, 0x30, 0x30,
    0x30, 0x0d, 0x0a, 0xb8, 0x50, 0x4d, 0x82, 0xa0, 0xa6, 0x64, 0x64, 0x68, 0x60, 0x96, 0x88, 0x6c,
    0x8c, 0xac, 0xa0, 0x64, 0x9c, 0x6c, 0x8a, 0xb0, 0x40, 0x40, 0x62, 0xae, 0x92, 0x88, 0x8a, 0x62,
    0x40, 0x61, 0x03, 0xf0, 0x3e, 0x31, 0x35, 0x32, 0x33, 0x34, 0x33, 0x7a, 0x5b, 0x32, 0x32, 0x34,
    0x5d, 0x2a, 0x57, 0x65, 0x20, 0x6b, 0x6e, 0x6f, 0x77, 0x20, 0x6d, 0x6f, 0x73, 0x74, 0x20, 0x6f,
    0x66, 0x20, 0x79, 0x6f, 0x75, 0x72, 0x20, 0x66, 0x61, 0x75, 0x6c, 0x74, 0x73, 0x21, 0x21, 0x21,
    0x0d, 0x71, 0x1f, 0x4d, 0x82, 0xa0, 0xa6, 0x64, 0x64, 0x68, 0x60, 0x96, 0x88, 0x6c, 0x8c, 0xac,
    0xa0, 0x64, 0x9c, 0x6c, 0x8a, 0xb0, 0x40, 0x40, 0xe2, 0xae, 0x92, 0x88, 0x8a, 0x62, 0x40, 0x61,
    0x03, 0xf0, 0x3e, 0x31, 0x35, 0x32, 0x33, 0x34, 0x33, 0x7a, 0x5b, 0x32, 0x32, 0x34, 0x5d, 0x2a,
    0x57, 0x65, 0x20, 0x6b, 0x6e, 0x6f, 0x77, 0x20, 0x6d, 0x6f, 0x73, 0x74, 0x20, 0x6f, 0x66, 0x20,
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
    0x40, 0xee, 0x9c, 0x6c, 0x8a, 0xb0, 0x40, 0x40, 0xe3, 0x03, 0xf0, 0x27, 0x2e, 0x5f, 0x7c, 0x6c,
    0x20, 0x74, 0x76, 0x2f, 0x5d, 0x22, 0x36, 0x5b, 0x7d, 0x0d, 0xb1, 0x03, 0x26, 0xa6, 0xa6, 0x6a,
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
};
