amedes/fx25-kiss-tnc/main/ax25.h

#ifndef __AX25_H__
#define __AX25_H__

#include <stdint.h>

#define GOOD_FCS 0xf0b8 // correct value if the packet includes fcs bytes

int ax25_fcs(uint8_t packet[], int packet_len);
int ax25_fcs_check(uint8_t buf[], int len);
int ax25_count_bit_length(uint8_t packet[], int length);
char *ax25_call_to_addr(const char *callsign);

#endif /* __AX25_H__ */
