amedes/fx25-kiss-tnc/(commit log)

2019-07-01 add KiCad files and manual
    [fx25tnc.kicad_pcb]
2019-07-19 correct wrong include file rmt.c to rmt.h
    [uart.c]
2019-07-19 add switch SW1 to parts list
2019-08-04 fixed src address of beacon packet
    [main.c]
2019-08-18 use rand_r() to prevent interferance between threads
    [tx_cntl.c]
2019-08-18 set 0x7e at first FX.25 frame byte before RS decode
2019-08-18 fix display of error correction in demo mode
    [main.c]
2019-08-19 fix AX.25 start flag overwriting error correction
    [fx25_decode.c, main.c]
2019-08-20 add display of Tag error in DEMO MODE
    [fx25_decode.c, main.c]
2019-08-20 add display of Reed Solomon decode error in DEMO MODE
    [main.c]
2019-08-20 modify burst error in DEMO MODE
    [rmt.c]
2019-08-21 add FX.25 FCS error count in DEMO MODE
    [main.c, rmt.c]
2019-08-21 modify Tag error count from 12 to 13
    [fx25_decode.c]
2019-08-21 modify Tag error count from 13 to 11
    [fx25_decode.c]
2019-08-21 modify Tag error count from 11 to 12 in DEMO MODE
    [fx25_decode.c]
2019-08-22 add error value in RS decode error message
    [rs.c]
2019-08-26 use esp_random() instead of rand_r() to adding noise in DEMO MODE
    [rmt.c]
2019-08-26 output number of bit errors in Tag
    [fx25_decode.c, main.c]
2019-08-26 modify output of Tag error in DEMO MODE
    [fx25_decode.c, main.c]
2019-08-27 fix Tag error bit output
    [fx25_decode.c]
2020-01-12 fixed ledc_init undefined error
    [ledc.c, main.c]
2020-06-21 fix strncat string length error
    [main.c]
2020-06-26 fixed wrong result of poly_div() if quotient is zero
    [poly.c]
2020-06-26 fixed the incompatibility problem with Direwolf's FX.25 packet
    [main.c, rs.c]
2021-01-01 fixed the imcompatibility of shotened RS code with Direwolf
    [fx25_decode.c, fx25_encode.c]
2021-04-22 fixed wrong filename freertos/FreeRTOS.h
    [main.c, tx_cntl.c]
